fordp2002/music2xxx/PCB/IGES/C320C104K5R5TA7305.step

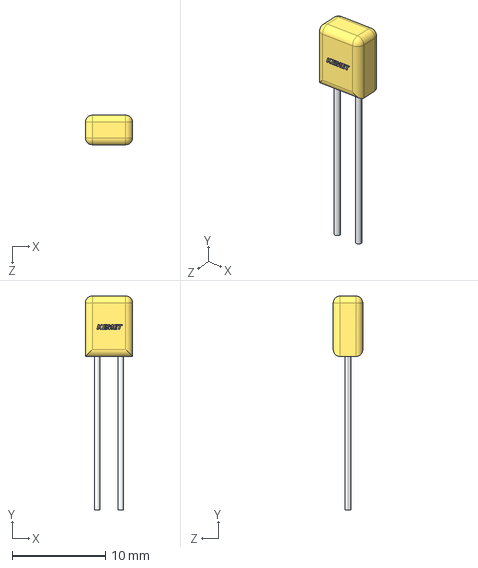
[picture p1: CAD file, 2025-04-03]
PCB/IGES/C320C104K5R5TA7305.step
5.08 x 23.0 x 3.19 mm
