fordp2002/music2xxx/PCB/IGES/DIP-8_AVA.iges

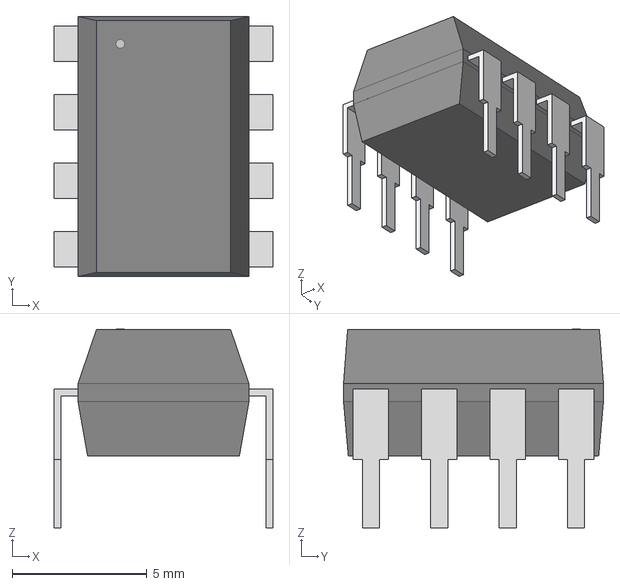
[picture p2: CAD file, 2025-04-03]
PCB/IGES/DIP-8_AVA.iges
8.13 x 9.65 x 7.37 mm
