fordp2002/music2xxx/PCB/IGES/KCDX-5S-N2_rA3.IGS

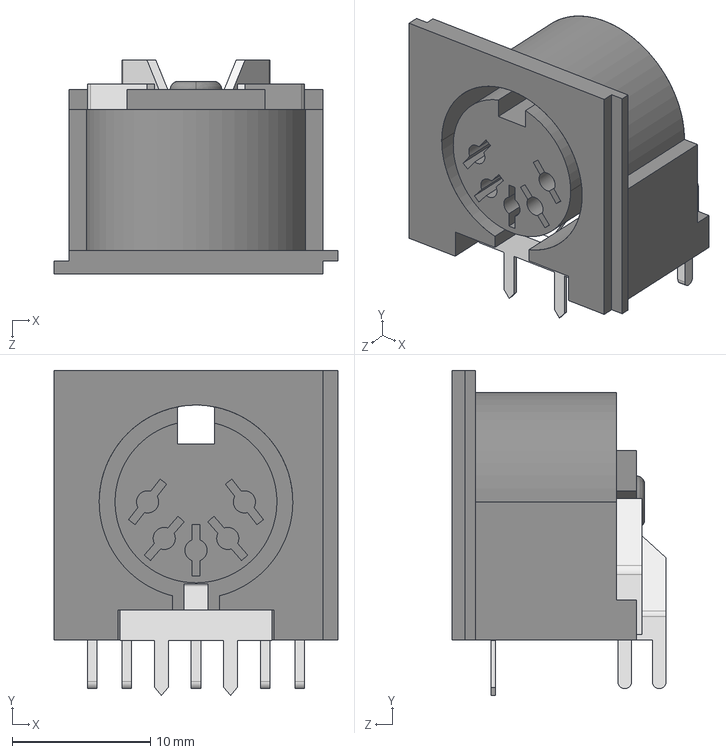
[picture p3: CAD file, 2025-04-03]
PCB/IGES/KCDX-5S-N2_rA3.IGS
20.5 x 23.5 x 15.5 mm
