fordp2002/music2xxx/PCB/UMI4M.kicad_pcb

## KiCad design PCB/UMI4M.kicad_pcb (2025-04-03)

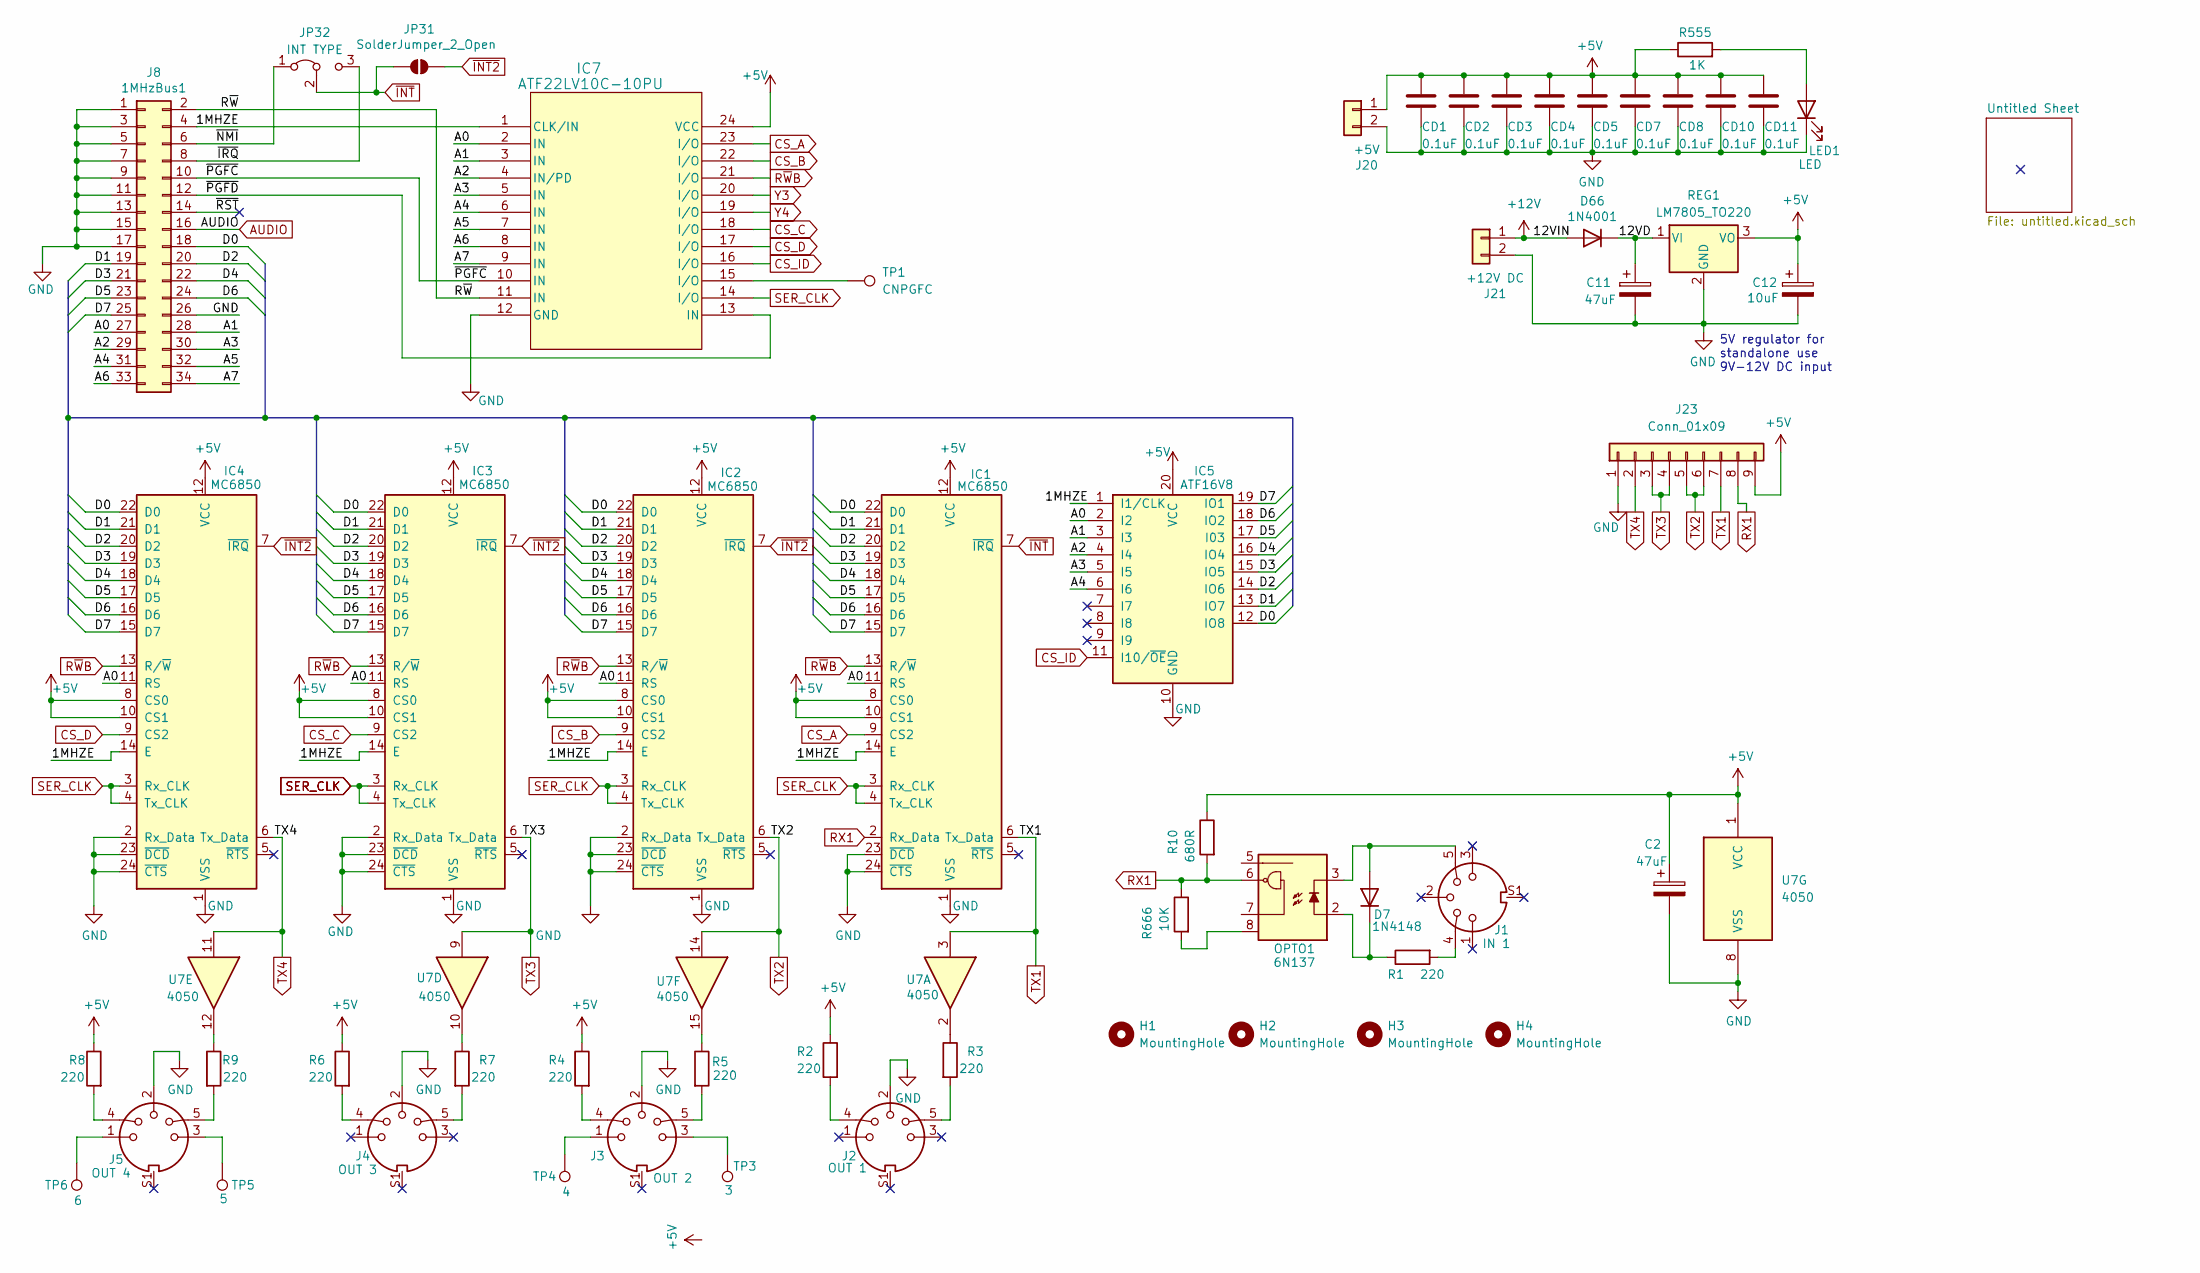
[picture p4: schematic UMI4M.kicad_sch, Uninvesal BBC MIDI Interface]

Parts:
C2: 47uF; CP_Radial_D5.0mm_P2.50mm
C11: 47uF; CP_Radial_D5.0mm_P2.00mm
C12: 10uF; CP_Radial_D5.0mm_P2.50mm
CD1, CD2, CD3, CD4, CD5, CD7, CD8, CD10, CD11: 0.1uF; C_Disc_D3.4mm_W2.1mm_P2.54mm
D7: 1N4148; D_DO-35_SOD27_P7.62mm_Horizontal
D66: 1N4001; D_DO-41_SOD81_P10.16mm_Horizontal
H1, H2, H3, H4: MountingHole; MountingHole_4.3mm_M4
IC1, IC2, IC3, IC4: MC6850; DIP-24_W15.24mm_Socket_LongPads
IC5: ATF16V8; DIP-20_W7.62mm_LongPads
IC7: ATF22LV10C-10PU; DIP-24_W7.62mm_Socket_LongPads
J1: IN 1; din_5_pcb_mount_umi
J2: OUT 1; din_5_pcb_mount_umi
J3: OUT 2; din_5_pcb_mount_umi
J4: OUT 3; din_5_pcb_mount_umi
J5: OUT 4; din_5_pcb_mount_umi
J8: 1MHzBus1; IDC-Header_2x17_P2.54mm_Vertical
J20: +5V; TerminalBlock_Phoenix_MKDS-1,5-2-5.08_1x02_P5.08mm_Horizont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
J21: +12V DC; TerminalBlock_Phoenix_MKDS-1,5-2-5.08_1x02_P5.08mm_Horizont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
J23: Conn_01x09; PinHeader_1x09_P2.54mm_Vertical
JP31: SolderJumper_2_Open; SolderJumper-2_P1.3mm_Open_RoundedPad1.0x1.5mm
JP32: INT TYPE; PinHeader_1x03_P2.54mm_Vertical
LED1: LED; LED_D5.0mm
OPTO1: 6N137; DIP-8_W7.62mm_LongPads
R1, R2, R3, R4, R5, R6, R7, R8, R9: 220; R_Axial_DIN0207_L6.3mm_D2.5mm_P10.16mm_Horizontal
R10: 680R; R_Axial_DIN0207_L6.3mm_D2.5mm_P10.16mm_Horizontal
R555: 1K; R_Axial_DIN0207_L6.3mm_D2.5mm_P10.16mm_Horizontal
R666: 10K; R_Axial_DIN0207_L6.3mm_D2.5mm_P10.16mm_Horizontal
REG1: LM7805_TO220; TO-220-3_Vertical
TP1: CNPGFC; TestPoint_THTPad_D2.0mm_Drill1.0mm
TP3: 3; TestPoint_THTPad_D2.0mm_Drill1.0mm
TP4: 4; TestPoint_THTPad_D2.0mm_Drill1.0mm
TP5: 5; TestPoint_THTPad_D2.0mm_Drill1.0mm
TP6: 6; TestPoint_THTPad_D2.0mm_Drill1.0mm
U7: 4050; DIP-16_W7.62mm_LongPads

Connections:
+5V: C2.1, C12.1, CD1.1, CD2.1, CD3.1, CD4.1, CD5.1, CD7.1, CD8.1, CD10.1, CD11.1, IC1.8 (CS0), IC1.10 (CS1), IC1.12 (VCC), IC2.8 (CS0), IC2.10 (CS1), IC2.12 (VCC), IC3.8 (CS0), IC3.10 (CS1), IC3.12 (VCC), IC4.8 (CS0), IC4.10 (CS1), IC4.12 (VCC), IC5.20 (VCC), IC7.24 (VCC), J20.1, J23.9, R2.1, R4.1, R6.1, R8.1, R10.1, R555.1, REG1.3 (VO), U7.1 (VCC); also elsewhere on the board
+12V: D66.2 (A), J21.1
/1MHZE: IC1.14 (E), IC2.14 (E), IC3.14 (E), IC4.14 (E), IC7.1 (CLK/IN), J8.4
/12VD: C11.1, D66.1 (K), REG1.1 (VI)
/A0: IC1.11 (RS), IC2.11 (RS), IC3.11 (RS), IC4.11 (RS), IC5.2 (I2), IC7.2 (IN), J8.27
/A1: IC5.3 (I3), IC7.3 (IN), J8.28
/A2: IC5.4 (I4), IC7.4 (IN/PD), J8.29
/A3: IC5.5 (I5), IC7.5 (IN), J8.30
/A4: IC5.6 (I6), IC7.6 (IN), J8.31
/A5: IC7.7 (IN), J8.32
/A6: IC7.8 (IN), J8.33
/A7: IC7.9 (IN), J8.34
/D0: IC1.22 (D0), IC2.22 (D0), IC3.22 (D0), IC4.22 (D0), IC5.12 (IO8), J8.18
/D1: IC1.21 (D1), IC2.21 (D1), IC3.21 (D1), IC4.21 (D1), IC5.13 (IO7), J8.19
/D2: IC1.20 (D2), IC2.20 (D2), IC3.20 (D2), IC4.20 (D2), IC5.14 (IO6), J8.20
/D3: IC1.19 (D3), IC2.19 (D3), IC3.19 (D3), IC4.19 (D3), IC5.15 (IO5), J8.21
/D4: IC1.18 (D4), IC2.18 (D4), IC3.18 (D4), IC4.18 (D4), IC5.16 (IO4), J8.22
/D5: IC1.17 (D5), IC2.17 (D5), IC3.17 (D5), IC4.17 (D5), IC5.17 (I03), J8.23
/D6: IC1.16 (D6), IC2.16 (D6), IC3.16 (D6), IC4.16 (D6), IC5.18 (IO2), J8.24
/D7: IC1.15 (D7), IC2.15 (D7), IC3.15 (D7), IC4.15 (D7), IC5.19 (IO1), J8.25
/R~W: IC7.11 (IN), J8.2
/~IRQ: J8.8, JP32.3 (B)
/~NMI: J8.6, JP32.1 (A)
/~PGFC: IC7.10 (IN), J8.10
/~PGFD: IC7.13 (IN), J8.12
/~RST: J8.14
AUDIO: J8.16; also elsewhere on the board
CS_A: IC1.9 (CS2), IC7.23 (I/O)
CS_B: IC2.9 (CS2), IC7.22 (I/O)
CS_C: IC3.9 (CS2), IC7.18 (I/O)
CS_D: IC4.9 (CS2), IC7.17 (I/O)
CS_ID: IC5.11 (I10/~OE), IC7.16 (I/O)
GND: C2.2, C11.2, C12.2, CD1.2, CD2.2, CD3.2, CD4.2, CD5.2, CD7.2, CD8.2, CD10.2, CD11.2, IC1.1 (VSS), IC1.23 (~DCD), IC1.24 (~CTS), IC2.1 (VSS), IC2.2 (Rx_Data), IC2.23 (~DCD), IC2.24 (~CTS), IC3.1 (VSS), IC3.2 (Rx_Data), IC3.23 (~DCD), IC3.24 (~CTS), IC4.1 (VSS), IC4.2 (Rx_Data), IC4.23 (~DCD), IC4.24 (~CTS), IC5.10 (GND), IC7.12 (GND), J2.2, J3.2, J4.2, J5.2, J8.1, J8.3, J8.5, J8.7, J8.9, J8.11, J8.13, J8.15, J8.17, J8.26, J20.2, J21.2, J23.1, LED1.1 (K), REG1.2 (GND), U7.8 (VSS); also elsewhere on the board
unnamed: D7.2 (A), J1.5, OPTO1.3
unnamed: D7.1 (K), OPTO1.2, R1.1
unnamed: IC7.15 (I/O), TP1.1
unnamed: J1.4, R1.2
unnamed: J2.4, R2.2
unnamed: J2.5, R3.2
unnamed: J3.1, TP4.1
unnamed: J3.3, TP3.1
unnamed: J3.4, R4.2
unnamed: J3.5, R5.2
unnamed: J4.4, R6.2
unnamed: J4.5, R7.2
unnamed: J5.1, TP6.1
unnamed: J5.3, TP5.1
unnamed: J5.4, R8.2
unnamed: J5.5, R9.2
unnamed: LED1.2 (A), R555.2
unnamed: OPTO1.8, R666.2
unnamed: R3.1, U7.2
unnamed: R5.1, U7.15
unnamed: R7.1, U7.10
unnamed: R9.1, U7.12
RX1: IC1.2 (Rx_Data), J23.8, OPTO1.6, R10.2, R666.1
R~WB: IC1.13 (R/~W), IC2.13 (R/~W), IC3.13 (R/~W), IC4.13 (R/~W), IC7.21 (I/O)
SER_CLK: IC1.3 (Rx_CLK), IC1.4 (Tx_CLK), IC2.3 (Rx_CLK), IC2.4 (Tx_CLK), IC3.3 (Rx_CLK), IC3.4 (Tx_CLK), IC4.3 (Rx_CLK), IC4.4 (Tx_CLK), IC7.14 (I/O)
TX1: IC1.6 (Tx_Data), J23.7, U7.3
TX2: IC2.6 (Tx_Data), J23.5, J23.6, U7.14
TX3: IC3.6 (Tx_Data), J23.3, J23.4, U7.9
TX4: IC4.6 (Tx_Data), J23.2, U7.11
Y3: IC7.20 (I/O); also elsewhere on the board
Y4: IC7.19 (I/O); also elsewhere on the board
~INT2: IC2.7 (~IRQ), IC3.7 (~IRQ), IC4.7 (~IRQ), JP31.2 (B)
~INT: IC1.7 (~IRQ), JP31.1 (A), JP32.2 (C)

Notes on the sheet:
5V regulator for standalone use 9V-12V DC input

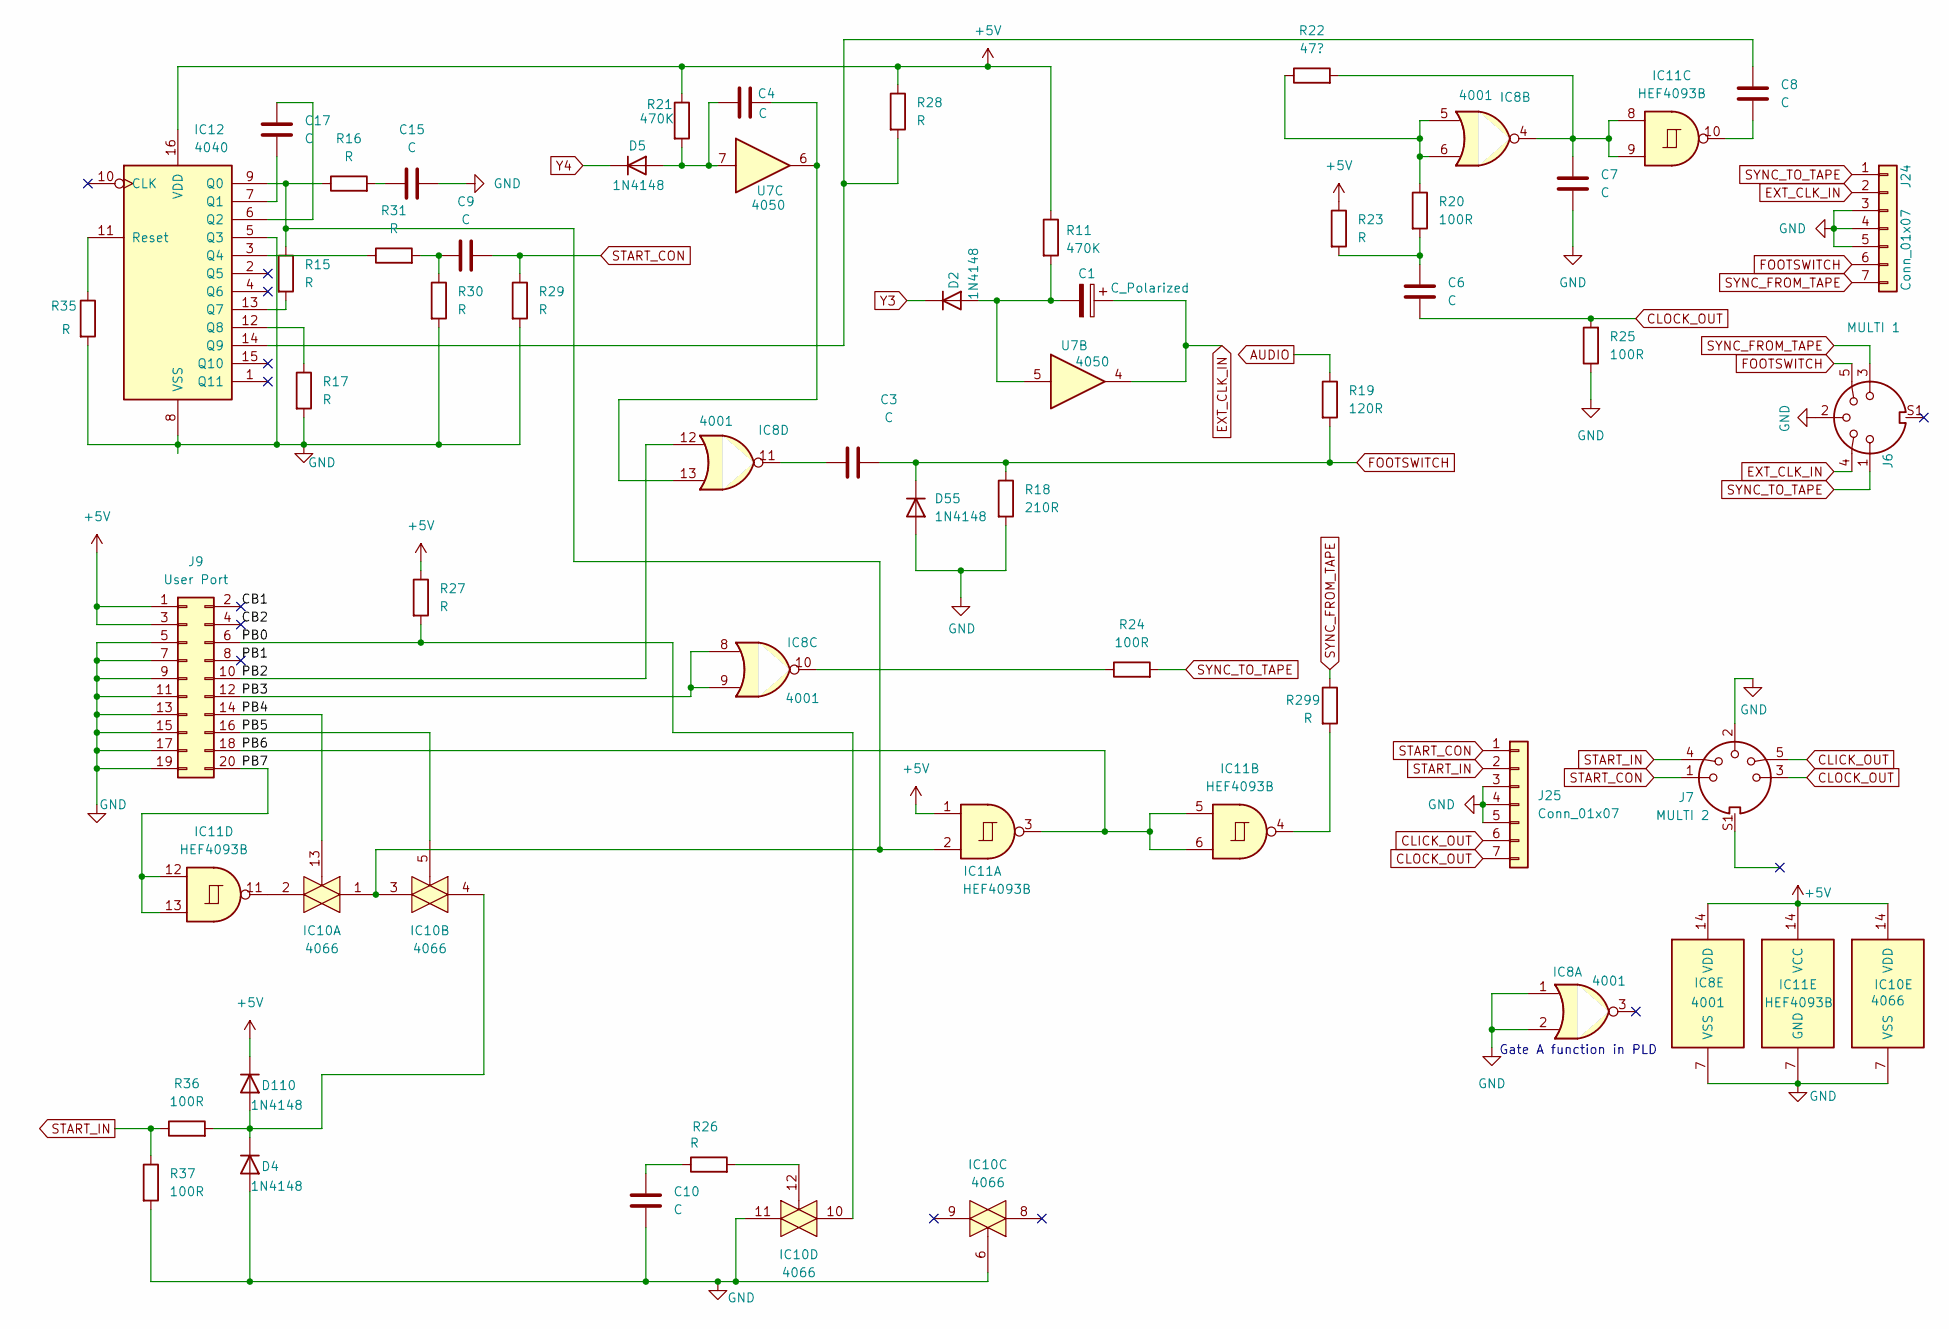
[picture p5: schematic untitled.kicad_sch]

Parts:
C1: C_Polarized; CP_Radial_Tantal_D4.5mm_P2.50mm
C3, C4, C8, C9, C10: C; C_Disc_D7.5mm_W2.5mm_P5.00mm
C6, C7, C15, C17: C; C_Disc_D3.4mm_W2.1mm_P2.50mm
D2, D4, D5, D55, D110: 1N4148; D_DO-35_SOD27_P7.62mm_Horizontal
IC8: 4001; DIP-14_W7.62mm_Socket_LongPads
IC10: 4066; DIP-14_W7.62mm_Socket_LongPads
IC11: HEF4093B; DIP-14_W7.62mm_Socket_LongPads
IC12: 4040; DIP-16_W7.62mm_Socket_LongPads
J6: MULTI 1; din_5_pcb_mount_umi
J7: MULTI 2; din_5_pcb_mount_umi
J9: User Port; IDC-Header_2x10_P2.54mm_Vertical
J24, J25: Conn_01x07; PinHeader_1x07_P2.54mm_Vertical
R11, R21: 470K; R_Axial_DIN0207_L6.3mm_D2.5mm_P10.16mm_Horizontal
R15, R16, R17, R23, R26, R27, R28, R29, R30, R31, R35, R299: R; R_Axial_DIN0207_L6.3mm_D2.5mm_P10.16mm_Horizontal
R18: 210R; R_Axial_DIN0207_L6.3mm_D2.5mm_P10.16mm_Horizontal
R19: 120R; R_Axial_DIN0207_L6.3mm_D2.5mm_P10.16mm_Horizontal
R20, R24, R25, R36, R37: 100R; R_Axial_DIN0207_L6.3mm_D2.5mm_P10.16mm_Horizontal
R22: 47?; R_Axial_DIN0207_L6.3mm_D2.5mm_P10.16mm_Horizontal
U7: 4050; DIP-16_W7.62mm_LongPads

Connections:
+5V: D110.1 (K), IC8.14 (VDD), IC10.14 (VDD), IC11.1, IC11.14 (VCC), IC12.16 (VDD), J9.1, J9.3, R11.1, R21.1, R23.1, R27.1, R28.1; also elsewhere on the board
/Untitled Sheet/CB1: J9.2
/Untitled Sheet/CB2: J9.4
/Untitled Sheet/PB0: IC10.10, J9.6, R27.2
/Untitled Sheet/PB1: J9.8
/Untitled Sheet/PB2: IC8.12, J9.10
/Untitled Sheet/PB3: IC8.8, IC8.9, J9.12
/Untitled Sheet/PB4: IC10.13, J9.14
/Untitled Sheet/PB5: IC10.5, J9.16
/Untitled Sheet/PB6: IC11.3, IC11.5, IC11.6, J9.18
/Untitled Sheet/PB7: IC11.12, IC11.13, J9.20
AUDIO: R19.1; also elsewhere on the board
CLICK_OUT: J7.5, J25.6
CLOCK_OUT: C6.2, J7.3, J25.7, R25.2
EXT_CLK_IN: C1.1, J6.4, J24.2, U7.4
FOOTSWITCH: C3.2, D55.1 (K), J6.5, J24.6, R18.1, R19.2
GND: C7.2, C10.2, C15.2, D4.2 (A), D55.2 (A), IC8.1, IC8.2, IC8.7 (VSS), IC10.6, IC10.7 (VSS), IC10.11, IC11.7 (GND), IC12.5 (Q3), IC12.8 (VSS), J6.2, J7.2, J9.5, J9.7, J9.9, J9.11, J9.13, J9.15, J9.17, J9.19, J24.3, J24.4, J24.5, J25.3, J25.4, J25.5, R17.2, R18.2, R25.1, R29.2, R30.2, R35.2, R37.2; also elsewhere on the board
unnamed: C3.1, IC8.11
unnamed: C4.1, IC8.13, U7.6
unnamed: C6.1, R20.2, R23.2
unnamed: C7.1, IC8.4, IC11.8, IC11.9, R22.2
unnamed: C8.2, IC11.10
unnamed: C9.1, R30.1, R31.2
unnamed: C10.1, R26.1
unnamed: C15.1, R16.2
unnamed: C1.2, D2.2 (A), R11.2, U7.5
unnamed: C4.2, D5.2 (A), R21.2, U7.7
unnamed: D4.1 (K), D110.2 (A), IC10.4, R36.2
unnamed: IC8.5, IC8.6, R20.1, R22.1
unnamed: IC8.10, R24.1
unnamed: IC10.2, IC11.11
unnamed: IC10.12, R26.2
unnamed: IC11.4, R299.2
unnamed: IC10.1, IC10.3, IC11.2, IC12.9 (Q0), R15.1, R16.1
unnamed: C17.2, IC12.7 (Q1)
unnamed: C17.1, IC12.6 (Q2)
unnamed: IC12.3 (Q4), R31.1
unnamed: IC12.13 (Q7), R15.2
unnamed: IC12.12 (Q8), R17.1
unnamed: C8.1, IC12.14 (Q9), R28.2
unnamed: IC12.11 (Reset), R35.1
START_CON: C9.2, J7.1, J25.1, R29.1
START_IN: J7.4, J25.2, R36.1, R37.1
SYNC_FROM_TAPE: J6.3, J24.7, R299.1
SYNC_TO_TAPE: J6.1, J24.1, R24.2
Y3: D2.1 (K); also elsewhere on the board
Y4: D5.1 (K); also elsewhere on the board

Notes on the sheet:
Gate A function in PLD

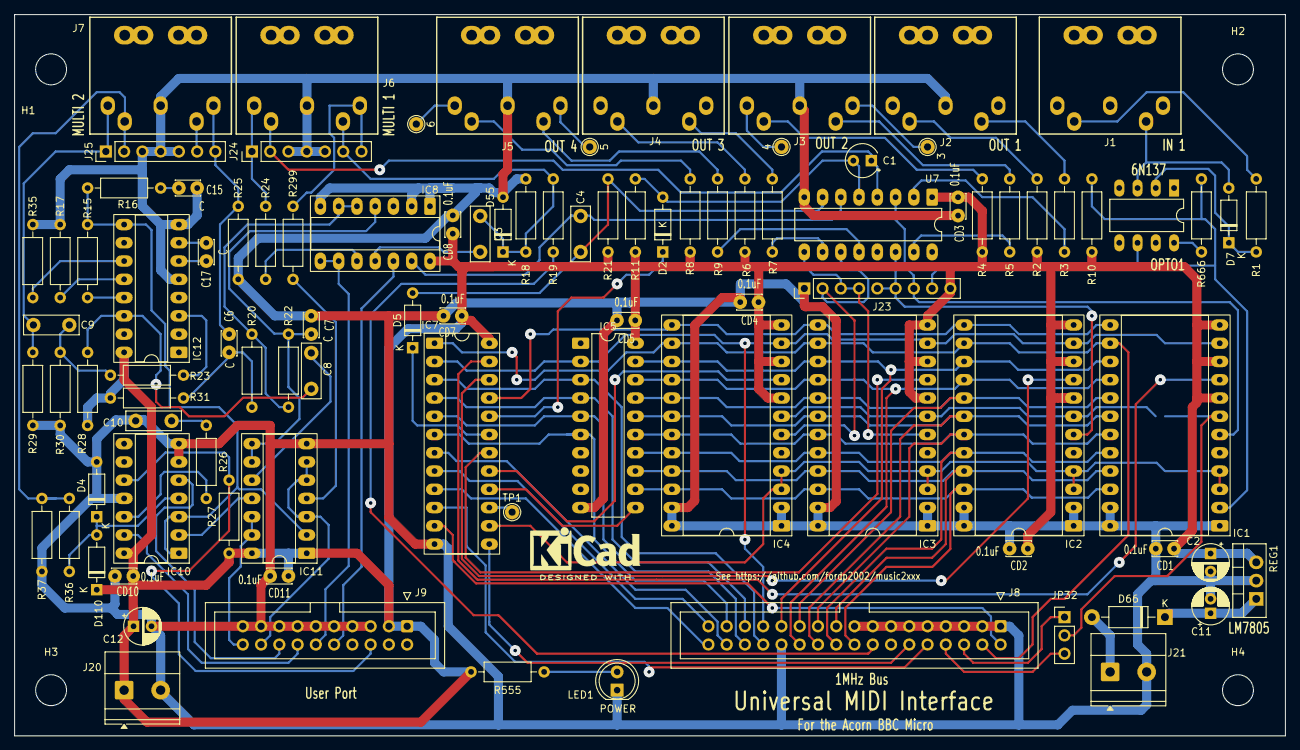
[picture p6: board UMI4M.kicad_pcb from above]

Board: 2 copper layers, 176.8 x 100.3 mm, 102 parts (1 on the bottom side), 104 nets.
