fordp2002/music2xxx/(commit log)

2025-03-03 WIP Universal MIDI Interface
    [UMI4M.kicad_pcb, UMI4M.kicad_sch, UMI4M.sch]
2026-11-11 Fix formatting and update UMI 4M and POWERTRAN entries
